xdze2/trois_molettes/docs/README.md

# Design docs

Requirements, part choices, and circuit/firmware design for the TroisMolettes AC
remote. There is no separate overview doc: start with
[00_specifications.md](00_specifications.md) for the requirements and the
stateless-interface principle, then each numbered file goes deep on one subsystem
(the `A*` files are technical annexes — reference, not reading order). Full file
list: see the table in the [root README](../README.md#files). Bench logs (what's
proven on real hardware) are in [`../howtos/`](../howtos/).

For what v1 leaves open and the planned v1.2 / v2 milestones (power, PCB,
enclosure), see [roadmap.md](roadmap.md).
