xdze2/trois_molettes/images/circuit/rc001.png

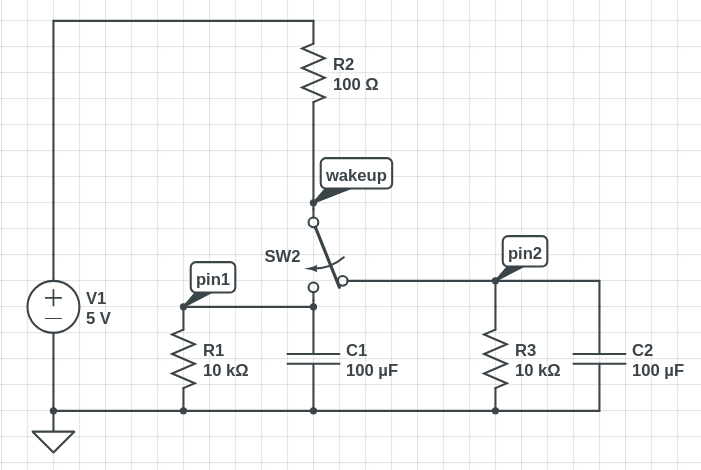
images/circuit/rc001.png
