xdze2/trois_molettes/images/daikin_remote_web.png

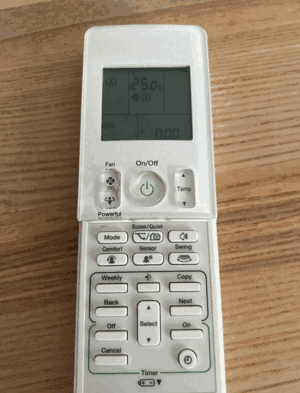
images/daikin_remote_web.png
