xdze2/trois_molettes/images/daikin_unit_web.png

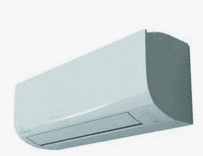
images/daikin_unit_web.png
