xdze2/trois_molettes/images/inspi_web.png

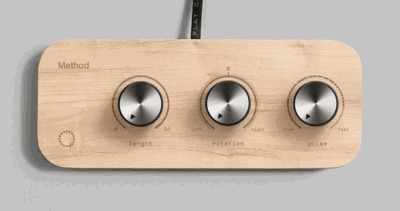
images/inspi_web.png
