xdze2/trois_molettes/images/photos/PXL_20260619_180518531_web.jpg

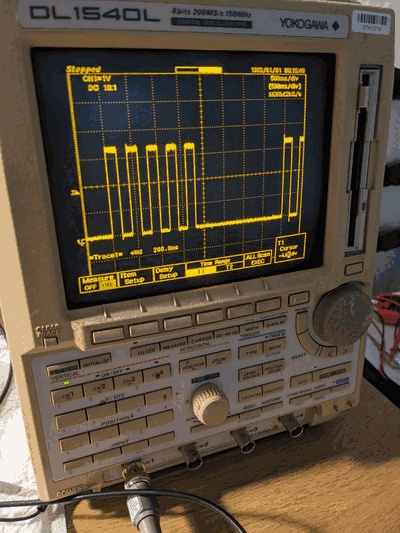
images/photos/PXL_20260619_180518531_web.jpg
