xdze2/trois_molettes/images/photos/PXL_20260624_193416426_web.jpg

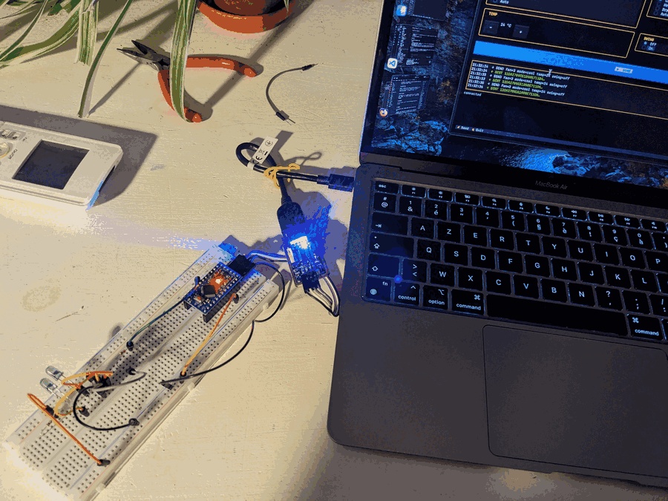
images/photos/PXL_20260624_193416426_web.jpg
