xdze2/trois_molettes/images/rotary_switch/ SR1712F-0108_alpha_web.png

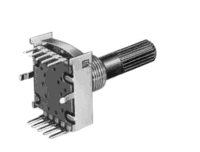
images/rotary_switch/ SR1712F-0108_alpha_web.png
