xdze2/trois_molettes/images/rotary_switch/ec11_web.png

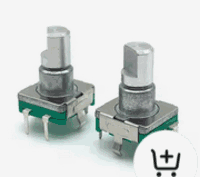
images/rotary_switch/ec11_web.png
