xdze2/trois_molettes/images/rotary_switch/Grayhill_56_web.png

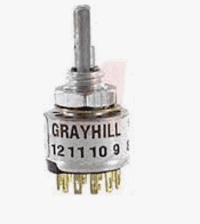
images/rotary_switch/Grayhill_56_web.png
