xdze2/trois_molettes/images/rotary_switch/ky040_ec11_web.png

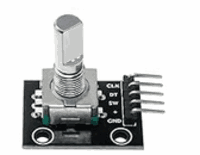
images/rotary_switch/ky040_ec11_web.png
