xdze2/trois_molettes/images/rotary_switch/NKK_MR-K112_web.png

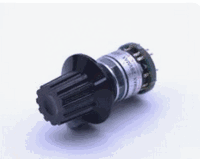
images/rotary_switch/NKK_MR-K112_web.png
