xdze2/trois_molettes/images/rotary_switch/sr10010F_Alpha_web.png

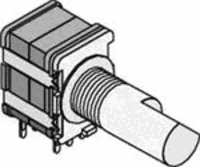
images/rotary_switch/sr10010F_Alpha_web.png
