xdze2/trois_molettes/images/shopping_cards.png

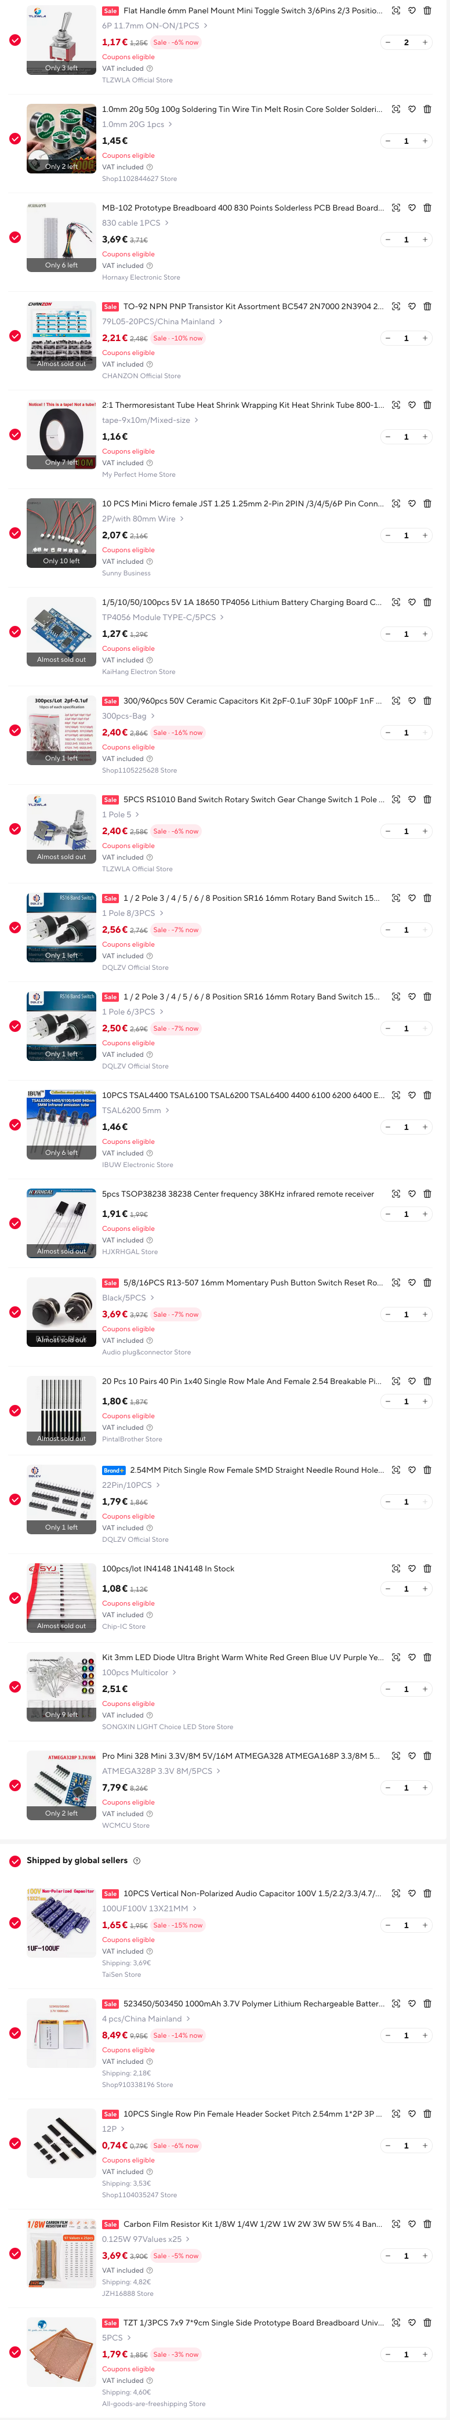
images/shopping_cards.png
