xdze2/trois_molettes/docs/06_IR_LED_wiring.md

# 06 — IR LED Wiring (TSAL6200)

Target: **ATmega328P Pro Mini 3.3 V**, powered from 2× AA/AAA or Li-Po (~3.0–3.3 V).
No boost converter — everything runs at 3.3 V.

## TSAL6200 Key Specs

| Parameter | Value |
|---|---|
| Peak wavelength | 940 nm |
| Max continuous current (If) | 100 mA |
| Max peak current (pulsed, 1/3 duty) | 1 A |
| Forward voltage (Vf @ 100 mA) | ~1.35 V |
| Half-angle | ±17° |
| Radiant intensity @ 100 mA | ~80 mW/sr |

The ±17° beam is focused — useful for range, but alignment matters.

## ATmega328P GPIO Constraints

- GPIO max source current: 40 mA per pin (20 mA recommended)
- A transistor is required to drive the LED at useful power

## Headroom at 3.3 V

```
Available across resistor = Vcc - Vf - Vce_sat
                          = 3.3V - 1.35V - ~0.2V  ≈  1.75 V
```

Vf rises slightly at high current (~1.5 V at 300 mA) — keep per-LED current at
**100 mA max** to stay in a predictable operating region with this supply.

## Single LED — Basic Circuit

Drive at **100 mA peak, 38 kHz, 1/3 duty cycle**.

```
R = (3.3V - 1.35V) / 0.1A = 19.5 Ω  → use 18 Ω or 22 Ω
R_base = 2.2 kΩ  (GPIO at 3.3V: 3.3V / 2.2kΩ ≈ 1.5 mA into base, hFE×Ic headroom fine)
```

**Transistor:** S9013 H331 (Ic_max 500 mA, TO-92) — well within ratings.

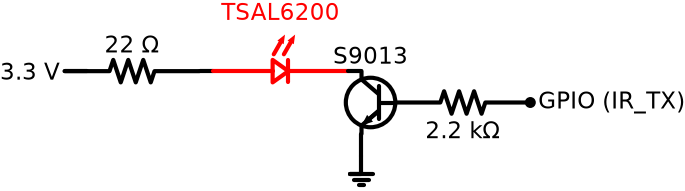
[picture p26: schematics/ir_led_single.png]
Single LED circuit


Current flows left → right: **3.3 V → 22 Ω → LED → transistor → GND**.

**Package orientation (TSAL6200, 5 mm radial):**

- **Anode** (long lead, round side of the package) faces the **22 Ω resistor / 3.3 V** side.
- **Cathode** (short lead, marked by the **flat** on the package rim) faces the **transistor collector** side.
- So the **flat faces the transistor**. Current path: 3.3 V → R → anode → cathode → collector → emitter → GND.

**S9013 (NPN, TO-92, flat face forward): E – B – C** (left to right, per datasheet):

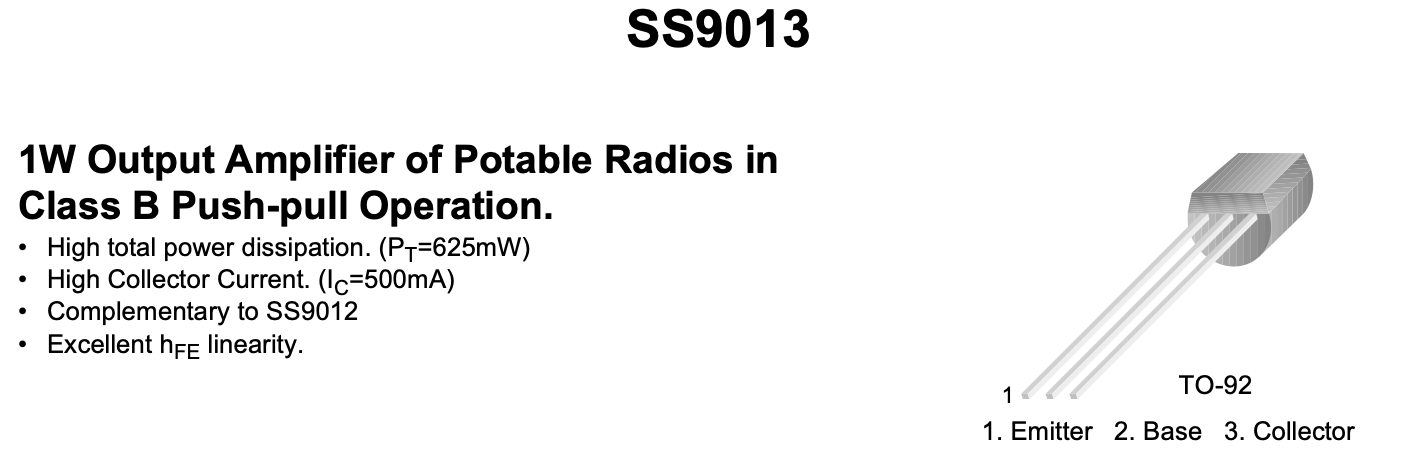
[picture p27: images/transistor_ss9013.png]
S9013 TO-92 pinout


- **Emitter (E, left)** → **GND**.
- **Base (B, centre)** → through R_base (2.2 kΩ) to the **GPIO**.
- **Collector (C, right)** → the **LED cathode**.

Range: ~2–3 m with a single LED at 100 mA. Use the multi-LED version for 3–4 m.

## Multi-LED Version — Widening the Angle

3 LEDs pointed in different directions (0°, ±30°) widens coverage to ~±47°,
and triples total radiant power for better range.

### Wiring: 3 LEDs in parallel, each with its own series resistor

Each LED gets its own resistor to balance current (never share a single resistor).

```
If per LED  = 100 mA
If_total    = 3 × 100 mA = 300 mA  →  S9013 (500 mA) handles this comfortably
R per LED   = (3.3V - 1.35V) / 0.1A = 19.5 Ω  → use 18 Ω or 22 Ω each

R_base (3× LEDs): Ib needed = Ic / hFE_min = 300 mA / 144 ≈ 2.1 mA
                  With 2× saturation margin: Ib_target ≈ 4.2 mA
                  R_base = (3.3V - 0.7V) / 4.2 mA ≈ 620 Ω  → use 680 Ω
```

> **Do not reuse the single-LED R_base of 2.2 kΩ here.** At 300 mA collector
> current, 2.2 kΩ gives only ~1.4 mA base current — below the ~2.1 mA needed
> for saturation. The transistor stays in active region, Vce rises to ~0.8 V,
> and LED current is lower than calculated.

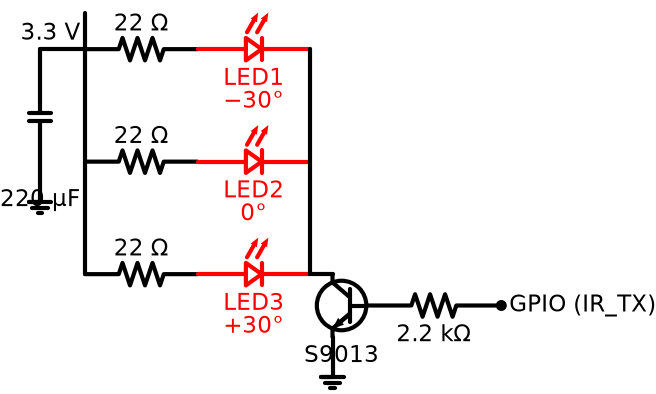
[picture p28: schematics/ir_led_3x.png]
3-LED circuit with bulk cap


### Angular coverage

| Config | Half-angle | Effective coverage |
|---|---|---|
| 1 LED | ±17° | ~34° cone |
| 3 LEDs (0°, ±30°) | ±17° each | ~±47° effective |
| 3 LEDs (0°, ±45°) | ±17° each | ~±62° effective |

## Bulk Capacitor — Rail Stabilisation

2× AA batteries have significant internal resistance (~0.5–2 Ω, rising toward end of life).
A 300 mA IR pulse causes a rail sag that can reset the MCU:

```
Sag = If_peak × R_internal = 300 mA × 1.5 Ω = 0.45 V  ← dangerously close to MCU brownout
```

A bulk capacitor placed close to the transistor/VCC node supplies the transient current
locally and keeps the rail stable. It does not increase LED current — it prevents the
voltage from drooping below the calculated value.

**Sizing:**
```
C ≥ If_peak × t_pulse / ΔV_allowed
  = 300 mA × 600 µs / 0.1 V
  ≈ 1800 µF for ΔV < 100 mV
```

In practice a single large cap isn't needed — the Daikin frame is a series of short
bursts, and the battery recovers between marks. **100–470 µF** is the practical range:

| Value | Notes |
|---|---|
| 100 µF | Minimum — fine for fresh batteries |
| 220 µF | Good default |
| 470 µF | More comfortable at end-of-life batteries |

Use an electrolytic, placed physically close to the collector/VCC node. Polarity matters.

## Wall-Mount Coverage — Wide Angle vs. Range

The TSAL6200's ±17° half-angle is chosen for range, which cuts against a
wall-mounted remote that could sit on any wall and must reach an AC unit
somewhere in the room. The instinct is "use a wide-angle LED," but that trades
away the wrong thing: the same radiant flux spread over a wider solid angle means
lower intensity in every direction (conservation of étendue). Wide-angle IR parts
(OP165W ±90° ~0.5 mW, OP293 ±30° low output) are low-power signalling emitters,
~10–100× weaker than the TSAL6200 — swapping to one guts the range. Don't
downgrade the emitter to buy angle.

Two things work in our favour instead: IR bounces well off walls/ceiling/furniture,
so direct line-of-sight across a full hemisphere usually isn't needed; and the AC
unit sits in a fixed, known direction, so the remote only needs to cover that arc
plus spill for bounce — not a true 180°.

### Strategy A — Multi-LED fan (keep the strong emitter)

3–5× TSAL6200 fanned across the horizontal (e.g. 0°, ±40°, ±80°) gives a
near-continuous high-intensity fan approaching ~160–180° with full range the whole
way. 5 LEDs at ~60 mA each = 300 mA still fits the S9013 (500 mA). Build the
documented 3× version and test in the real room first — direct + bounce often
covers more than the angle math suggests.

### Strategy B — Optics (aesthetic + horizontal beam-shaping)

A lens can't create coverage, only redistribute flux the LED already emits — a
symmetric diffuser turns a strong narrow LED into a weak wide one. But shaping is
useful: a cylindrical/lenticular lens spreads the beam horizontally while keeping
it tight vertically (floor/ceiling flux is wasted on a wall mount anyway; can turn
±17° symmetric into ~±50° H / ±17° V), and a tinted IR-pass window (the dark-red
plastic over every TV remote) hides the LEDs at near-zero optical cost — worth
doing regardless. Optics are for aesthetics and horizontal shaping, not a
substitute for multiple emitters.

### Strategy C — Aimable head (directional mount)

Sidesteps the étendue problem: keep the TSAL6200's full focused beam and aim it
once at install time. The AC never moves, so this is a mechanical positioning
problem, not a motor problem — skip motorised aiming, since a servo adds power
draw (bad for a µA-sleep battery remote) and noise for no benefit once set.

| Mechanism | Axes | Wiring across joint | Notes |
|---|---|---|---|
| **Ball-and-socket / friction gimbal** | pan + tilt | flexible leads / flat-flex through socket | Recommended. GoPro/camera-ball style, friction holds aim, no power to hold |
| Detented turntable | pan only | flex with ±180° stop, or keep PCB on platter | Click detents like a thermostat dial; slip-ring is overkill |
| Flip-up hinge panel | tilt only | hinge-routed leads | Friction hinges, good if AC is roughly in front |

A small reflector cup or lens hood behind the LED tightens the on-axis beam for
extra range and a clear "this points at your unit" affordance. Keep 3× TSAL6200
in the head for install tolerance.

**Recommendation order:** build the 3× fan and test in-room → if dead spots, go
5× fan → add lenticular/diffuser + tinted window for blend & aesthetics → use an
aimable friction-gimbal head if focused range with a deliberate point-at-the-AC
interaction is wanted.

## Component Summary

| Component | Value | Notes |
|---|---|---|
| TSAL6200 | × 1 or × 3 | 940 nm, ±17°, 100 mA |
| Q1 NPN | S9013 H331 | Ic 500 mA, hFE 144–202 (H group), TO-92, EBC pinout |
| R_base | 2.2 kΩ (1× LED) / 680 Ω (3× LEDs) | GPIO → base; value depends on total Ic |
| R_series | 22 Ω each | 100 mA per LED at 3.3 V |
| C_bulk | 220 µF electrolytic | rail stabilisation, close to Q1 collector |

## Notes

- **S9013 pinout (TO-92, flat face forward): E – B – C** (left to right, per datasheet). Same order as BC337 — but always verify against the datasheet before soldering, since other 9013 variants and clones sometimes differ.
- At 1/3 duty cycle (Daikin/NEC encoding), average current per LED is ~33 mA — well within continuous ratings.
- The IRremote library (AVR target) handles the 38 kHz carrier via timer — no manual toggling needed. **The send pin must be a hardware timer output: use pin 3 (OC2B, Timer 2, IRremote default).** Arbitrary GPIO pins (e.g. pin 2) only produce the mark/space envelope without the 38 kHz carrier — the AC will not respond.
- For the multi-LED version, bend the outer LEDs to the target angle before soldering; a small cardboard jig helps keep angles consistent.
- Desolder the Pro Mini power LED before measuring sleep current — it draws ~1 mA continuously and dominates the sleep budget.
