xdze2/trois_molettes/datasheets/rs1010_wiring.webp

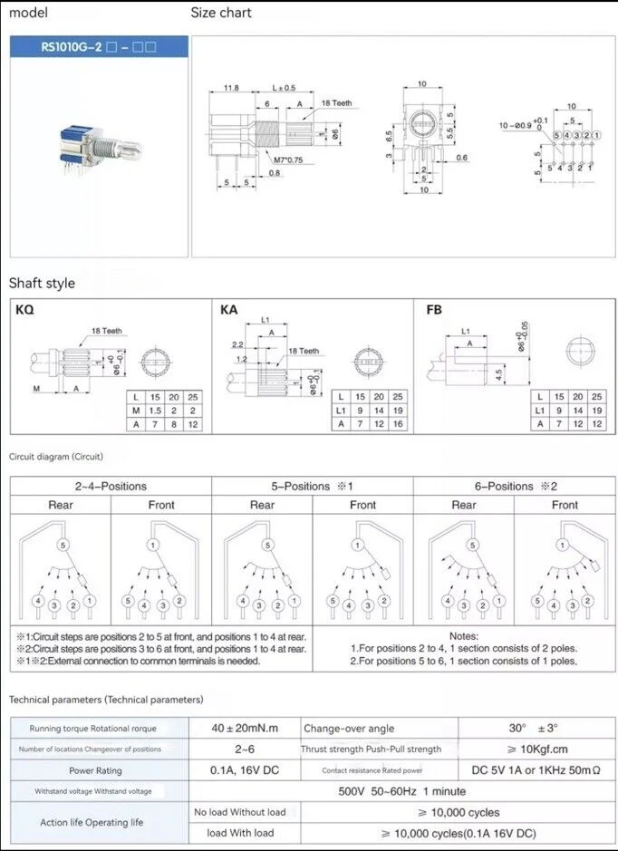
datasheets/rs1010_wiring.webp
