xdze2/trois_molettes/(commit log)

2026-06-02 Init draft project
    [02_BOM_prototype.csv]
2026-06-02 Update rotary switches
2026-06-03 Revise wake/readout design, split electronics into 05
    - Fix wake mechanism: alternating-contact 2P pole (was "all contacts to
    3.3V", which collapsed into the rejected float method)
    - Add honest battery budget: stock Pico ~1.3 mA, gated ladder rail, 6-month
    target as open bench-validation item
    - Drop WS2812B chain (incompatible with battery target; knob position is the
    state)
    - Extract circuit-level content into new 05_electronics_circuit.md; 04 keeps
    switch selection only
    - Reconcile mode count (4), BOM 2P parts, gated rail, cross-references
    [02_BOM_prototype.csv]
2026-06-03 Converge on diode-encoded 1P switch readout; restructure docs
    Design decision: all three rotary switches are plain 1-pole, diode-encoded
    into a small binary code on their own GPIO; the code lines double as
    both-edge wake interrupts. Drops 2-pole switches, resistor ladders, ADC,
    analog rail, and comparator — switches now chosen on feel and size alone.
    - Document Options C (off-the-shelf coded switch) and D (DIY diode-encoded)
    alongside the earlier A/B; mark A/B/C considered, D chosen
    - Fix wake: per-line both-edge interrupts, not a single OR'd pin (which
    misses non-zero->non-zero moves)
    - Fix power coupling: wiper supply can't be gated (kills wake); use weak
    pull-downs for low leakag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
    [02_BOM_prototype.csv]
2026-06-03 Rethink MCU choice on sleep current + 13-pin wake; drop RP2040
    The device sleeps ~100% of the time, so sleep current is effectively the
    whole battery budget, and the diode-encoded readout needs both-edge wake
    on ~13 GPIO. Reframe the MCU constraints around these two (plus a
    perfboard/dev-board-only build rule), and demote the IR library to a
    convenience now that porting the Daikin frame is accepted.
    This inverts the previous pick: the RP2040 Pico board sleeps at ~1-1.8 mA
    (~9 weeks, misses 6 months) and its bare-chip fix needs a PCB the
    perfboard rule forbids; cheap ESP32-C parts expose only 6-8 deep-sleep
    wake pins (<13). New shortlist that clears both gates: nRF52840 (XIAO,
    preferred, ~1.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
    [02_BOM_prototype.csv]
2026-06-19 IR leds
2026-06-19 Add portable Daikin frame builder and software architecture doc
    - firmware/daikin_frame.{h,cpp}: pure C++ AC state → 35-byte frame builder,
    no library dependency, verified byte-for-byte against IRDaikinESP reference
    - ir_mock/main.cpp: updated to diff portable builder output against the full
    library; exits non-zero on any mismatch
    - 10_software_architecture.md: documents the 3-layer split (app / frame / HAL),
    Linux mock verification workflow, and open items
    - ir_mock/IRremoteESP8266: registered as git submodule
2026-06-21 Add wiring diag for the rs1010
2026-06-22 Add IRQ/LED test sketch, serial test sketch, and serial debug howto
    Documents the CKDIV8 fuse issue (4 MHz effective clock, baud rate
    factor-of-2 workaround) and explains BOD, ISP, and fuse options.
    [serial_test.ino]
2026-06-22 Add RS1010 readout test sketches and bench-notes howto
    Two sketches in tools/ for the diode-encoded rotary switch wiring:
    polling-only (rs1010_poll_test) and SLEEP_MODE_PWR_DOWN + PCINT wake
    (rs1010_wiring_test). Both implement the §7 two-agreeing-reads debounce
    to defeat the inter-detent zero glitch (10 ms settle, 5 ms was too low).
    howtos/03_rs1010_readout.md captures the bench findings and pitfalls
    (INPUT vs INPUT_PULLUP, millis() in power-down, LED_BUILTIN in PCI group).
2026-06-22 Update specs and circuit docs to reflect actual design choices
    - Controls: 8-pos SR16 for fan/temp, 5-pos RS1010 for mode, Send button, optional swing toggle
    - Temperature uses 2°C steps with mode-dependent offset (heating 14–28°C, cooling 20–34°C)
    - Add feedback LED (PC3) to GPIO listing
    - Rewrite 05_electronics_circuit.md focused on ATmega328P diode encoding (all 3-bit)
    - Add 07_battery_and_power.md covering power architecture, sleep budget, Pro Mini mods
    - Add bench photo and wiring schema to howtos/03_rs1010_readout.md
    - Ignore datasheets/ directory
2026-06-23 Add IR receiver signal howto with oscilloscope bench notes
    TSOP38238 circuit, measured Daikin frame structure (leader + 3 frames),
    and bit-level timing (475 µs mark, pulse-distance encoding), with photos.
2026-06-23 Ir led with S9013
2026-06-23 Tst ir led
2026-06-23 Add IR modulation test howto and rename sketches
    - Add howtos/05_ir_modulation_test.md with bench notes, scope images,
    and CKDIV8 timing workaround (HALF_PERIOD_US 4 → ~36 kHz measured)
    - Rename ir_led_test → ir_modulation_test to distinguish from upcoming
    Daikin protocol test
    - Rename irq_led_test → pcint_test to avoid confusion with IR sketches
    [ir_modulation_test.ino]
2026-06-23 Add daikin_fan_toggle sketch and howto
    First end-to-end test of a real Daikin frame over the IR LED: Timer2
    38 kHz carrier, portable frame builder, 3-section pulse encoder.
    Alternates fan MIN/MAX every 30 s so the AC unit itself is the loopback.
2026-06-23 Recalibrate Daikin carrier for 8 MHz and blink LED on send
    Scope measurement (66.7 kHz at OCR2A=58) proved CKDIV8 is not active,
    so the 4 MHz/CKDIV8 compensations were wrong: removed `/2` from
    delayMicroseconds(), set OCR2A=104 for 38.1 kHz, kept Serial at 4800
    baud as-is. LED_BUILTIN now lights for the duration of each frame
    plus 400 ms so transmissions are visible.
    Howto's "Clock note" section now documents the misdiagnosis and the
    measurement that disproved it — heads-up for the other sketches that
    still carry the same CKDIV8 assumption.
    [daikin_fan_toggle.ino]
2026-06-23 Resolve merge conflict in fan toggle howto
    Keep updated troubleshooting rows (4800 baud, OCR2A scope advice, symlink note)
    and status note from both sides.
2026-06-23 Add ir_rx_dump sketch and howto (not yet tested)
    Sketch listens on TSOP38238 (D2) and prints raw mark/space timings to
    serial — intended to capture the real Daikin remote output for byte-level
    comparison against daikin_build_frame().
2026-06-23 ir_rx_dump: iterate on timing capture, document failures and PCINT plan
    - Label output with LEADER/SECTION/--- markers for readability
    - Switch to 115200 baud to reduce Serial delay between measurements
    - Replace pulseIn() with micros()-based helpers, then hybrid approach
    (both failed: pulseIn(HIGH) misses in-progress spaces; micros() polling
    loop has 8 µs resolution at 8 MHz and misses short transitions)
    - Document root cause: no safe place for Serial.print in the polling hot
    loop given 400 µs bit spaces vs 35 ms inter-section gaps
    - Document recommended next approach: PCINT edge-timestamp ring buffer,
    decode and print after full frame captured (end-of-frame >60 ms timeout)
    Co-Au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
    [capture.py, ir_rx_dump.ino]
2026-06-23 Rename howtos 06↔07, add IDE settings image to ir_rx_dump
    - 06_daikin_fan_toggle → 07_daikin_fan_toggle
    - 07_ir_rx_dump → 06_ir_rx_dump (capture comes before toggle)
    - Add images/arduino_ide_settings.png (Pro Mini, ATmega328P 3.3V 8MHz)
    - Reference image in 06_ir_rx_dump.md under new Arduino IDE settings section
2026-06-23 ir_rx_dump: working PCINT capture + reference fan-loop dump
    The sketch now produces strict mark/space alternation and one === per
    button press. Three bring-up bugs fixed: phase detection (inverted
    PIND read in the ISR), torn read of last_edge_time in loop() that
    triggered premature decoding mid-signal, and mid-frame ISR re-arm on
    buffer overflow that lost ~50 ms of edges to Serial.print. Buffer
    grown to 768 entries to fit a full Daikin press (frame + repeat) in
    one capture.
    Captured reference: howtos/data/dump_fan_loop.txt — ARC466A33 cycling
    the full fan-speed loop (auto → 1..5 → quiet → auto), ten frames, for
    use as ground truth when developing the decoder.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
    [dump_fan_loop.txt]
2026-06-24 Fix daikin_frame fixed bytes to match real ARC466A33 capture
    Decoding the checked-in fan-loop capture (howtos/data/dump_fan_loop.txt)
    revealed that daikin_build_frame() — a faithful port of the library's
    stateReset() — emitted five reserved/fixed bytes that the real remote
    never sends as zero. Since the AC unit checksums each section, these
    mismatches likely explain why it ignored the ATmega.
    - frame[5]=0x10, frame[13]=0x04, frame[14]=0x20 (section 1/2 reserved+clock)
    - frame[31]=0xC1, frame[32]=0x80 (section 3 reserved bits)
    All five are invariant across all 10 captured frames.
    ir_mock now diffs the builder against the decoded capture (the real
    ground truth) instead of the library d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
    [main.cpp]
2026-06-24 daikin_fan_toggle: fix gap/header timing to match real capture
    Diffing the sketch's pulse encoding against the real ARC466A33 capture
    (decoded in howto 07) showed it used the library's nominal single 29 ms
    gap everywhere, but the real remote uses ~25 ms after the preamble and
    ~35 ms between sections.
    - Split DAIKIN_GAP into DAIKIN_LEADER_GAP (25 ms) and DAIKIN_SECTION_GAP
    (35 ms); send_section() now takes the gap as a parameter.
    - Nudge HDR mark/space to the measured ~3500 / ~1700 µs.
    - Frame content needs no sketch change: it flows from the already-fixed
    daikin_build_frame().
    Update howto 08 timings/structure and refresh the stale "does not
    respond" status: both root causes (checksum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
    [daikin_fan_toggle.ino]
2026-06-24 Fix S9013 pinout (E-B-C) and add visible-LED sanity check
    The S9013 datasheet pinout is E-B-C (centre = base), not E-C-B as howto 06
    previously claimed. The wrong pinout left the LED forward-biased through the
    base-emitter junction permanently — LED always on, GPIO toggling did almost
    nothing useful.
    The original modulation test (howto 05) still passed with the wrong wiring
    because a TSOP38238 at a few cm has enough AGC and sensitivity to demodulate
    the small 38 kHz ripple riding on the DC-on LED. That false positive is now
    documented as a trap.
    - 06_IR_LED_wiring.md: correct pinout to E-B-C with datasheet image
    - howtos/05_ir_modulation_test.md: add Step 0 visible-LED sanity check and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
    [ir_led_blink.ino]
2026-06-24 daikin_fan_toggle: fix long-gap truncation, working end-to-end
    delayMicroseconds() is only accurate up to ~16 ms, so the 25 ms leader
    and 35 ms inter-section gaps silently collapsed to near-zero and fused
    all three sections into one ~300 ms burst — AC ignored the frame.
    Add ir_space_long() that chunks long waits into 16 ms delay() slices,
    route the leader and section gaps through it. AC now beeps and changes
    fan speed on every transmission; reliable range ~2–3 m with a single LED.
    [daikin_fan_toggle.ino]
2026-06-24 docs: reconcile design docs to as-built (ATmega328P, IR on PD3/OC2B)
    The docs had drifted from the validated, tested design. Most important fix:
    the IR TX pin was documented as PD7 (OC2A) but the working end-to-end firmware
    drives PD3 (OC2B) via Timer2 — soldering to the doc'd pin would have used a
    dead GPIO. Corrected and marked PD3 as hardware-locked; reassigned Temp to
    PD4-6, Send to PD2, Swing to PD7 around it.
    Also reconciled:
    - MCU: nRF52840-as-preferred -> ATmega328P locked (README, 01, 10, 01_IR)
    - dead links: 07_power_and_ir.md -> 07_battery_and_power.md / 06_IR_LED_wiring.md
    - controls: 4 buttons -> Send + optional Swing
    - positions: stale 6/4/11 -> 8/5/8
    - sleep floor: nRF ~2uA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
2026-06-24 docs: link bench logs from README, fix stale refs in rs1010 howto
    Add a "Bench logs (build journal)" section to the README linking all eight
    howtos/ logs, and complete the design-docs Files table (was missing 06/07/10).
    The howtos are the real record of bringing each subsystem up on hardware.
    Reconcile drift in howtos/03_rs1010_readout.md:
    - cross-refs pointed to a §3.5/§6/§7/§8 layout 05 no longer has -> §2/§3/§5
    and the sleep budget now in 07_battery_and_power.md
    - "11-position temp switch needs 4 lines" -> final design is 8-pos / 3 lines
    - "final target MCU (nRF52840, ~2 uA floor)" -> ATmega328P, LDO ~75 uA floor
    06_IR_LED_wiring.md left out (separate pre-existing change).
    Co-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
2026-06-24 docs: add serial remote app (Textual TUI) spec
    Plan for a Python Textual soft front-panel that drives the real AC over
    serial -> ATmega328P -> IR LED, reusing the validated transmit path
    (daikin_build_frame -> send_daikin -> Timer2 carrier).
    Design keeps Python thin: the 328P owns the protocol (frame bytes,
    checksums, timing — already validated), the TUI sends intent as line
    commands (FAN/MODE/TEMP/SEND) and renders replies. Covers the serial
    protocol, a near-trivial daikin_serial firmware refactor, the app module
    layout (incl. a mock backend to build the UI with no board), and frame
    parity verification via the SENT <hex> reply.
    Linked from the README Files table.
    06_IR_LED_wiring.md le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
2026-06-24 docs: add integration roadmap to README
    Record the milestone (all three subsystems individually proven) and the
    three-phase integration plan, each phase de-risking the next:
    1. Python serial app — exercise the full control mapping from a TUI before
    committing it to physical knobs
    2. Wood-panel prototype — encoders + devboard + battery; settle LED mount,
    knob feel, real-room range, measured sleep current
    3. Proper case + better wiring (PCB?) — once the prototype fixes the real
    dimensions and layout
    Also fix two stale bits in the Hardware summary passed through: "4 tactile
    buttons" -> Send + optional Swing, and a dead section anchor on the 05 link.
    06_IR_LED_wiring.md left ou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
2026-06-24 daikin_tui: rewrite UI around single-source state, send-on-change
    - TUI: replace RadioSet/per-widget state with a central state dict in
    DaikinApp; OptionGroup and TempControl are stateless renderers driven
    by render_state(). Every picker click / temp bump / Enter on a focused
    button immediately sends the current snapshot. Green highlight tracks
    last-successfully-sent value, so the UI mirrors the AC's actual state.
    Standalone button kept as RESEND.
    - Arrow keys aliased to Tab/Shift-Tab at app level (pure focus motion,
    one focus indicator instead of two).
    - backend: swap pyserial-asyncio for blocking pyserial in to_thread —
    matches capture.py and dodges CH340 DTR reset quirks d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
    [app.py, backend.py, daikin_serial.ino]
2026-06-27 fix: correct R_base for 3-LED config and warn about IRremote pin requirement
    2.2 kΩ is insufficient to saturate the S9013 at 300 mA — use 680 Ω.
    Add warning that IRremote requires pin 3 (OC2B) for the 38 kHz carrier.
2026-07-08 docs: add Arduino Pro Mini pin map, battery wiring, and GPIO image
    - Add pin-assignment table with Arduino Pro Mini silkscreen labels
    alongside AVR port names in 05 §1.
    - Add power/non-GPIO table: TP4056 OUT+/OUT- -> Pro Mini RAW/GND.
    - Fix stale Send/Swing pins in §4 (PD5/PD6 -> PD2/PD7) to match §1.
    - Embed images/circuit/gpios.png.
2026-07-08 Revert ir led pin chg
    [ir_led_blink.ino]
2026-07-08 Add polling test sketch for all 3 rotary switches
    Reads Fan/Mode/Temp code lines and prints bits + decoded meaning on
    serial. Includes a raw-code -> position remap for the Fan switch
    (diode encoding is shifted by one position) and a capture.py helper
    matching the ir_rx_dump pattern.
2026-07-08 Document Fan/Mode rotary switch bring-up findings
    Bench notes on the diode-shift bug (Fan) and pin-swap bug (Mode) found
    via rotary_switches_poll_test, plus next steps: wire Temp, IR+Daikin
    end-to-end test, sleep mode, and battery test.
2026-07-08 Add daikin_knob_remote sketch: Fan/Mode knobs transmit IR on change
    Combines the validated Fan+Mode readout from rotary_switches_poll_test
    with the IR TX path from daikin_serial, wired straight from change-detect
    in the poll loop rather than a Send button. Confirmed against the real
    Daikin unit. Temp is not yet wired so it's held at a fixed default.
    [capture.py, daikin_knob_remote.ino]
2026-07-15 Wire Temp knob and Resend button; fix Resend pin polarity
    daikin_knob_remote: read the Temp switch (D4/D5/D6) instead of a fixed
    24C default, applying the mode-dependent 2C-step offset. Add a Resend
    button (D2) that retransmits the current knob state on demand, on top
    of the existing auto-send-on-knob-change behavior.
    rotary_switches_poll_test: add Resend button polling alongside the
    existing Fan/Mode/Temp switch readout.
    Both sketches originally assumed the design doc's pull-up/active-low
    wiring for the Resend button, but the bench wiring uses an external
    pull-down with the button to +3.3V (active-high), matching the rotary
    switch code-line convention. Fixed pinMode/polarity in both sketc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
    [daikin_knob_remote.ino, rotary_switches_poll_test.ino]
2026-07-15 Consolidate per-sketch capture.py into tools/serial_capture.py
    Three sketches each carried a near-identical pyserial capture helper.
    Replace them with one shared tool; the sketch-specific --sends-only /
    --changes-only flags become a generic repeatable -f/--filter-prefix.
    [capture.py, ir_rx_dump.ino, serial_capture.py]
2026-07-15 Consolidate GPIO input bring-up into one sketch; align its baud rate
    rotary_switches_poll_test now covers every GPIO input in the design
    (Fan/Mode/Temp rotary switches, Resend, and Swing) in a single polling
    loop, so it's the one sketch to reach for during input bring-up. Removes
    gpio_test, pcint_test, rs1010_poll_test, and rs1010_wiring_test, whose
    functionality it supersedes.
    Also switches it from 9600 baud (no clock fix) to 115200 with the CKDIV8
    clear used by daikin_serial/daikin_knob_remote/ir_rx_dump, so the whole
    modern sketch chain shares one baud rate and doesn't depend on whether
    the board's bootloader quirk is present.
    [rotary_switches_poll_test.ino]
2026-07-15 Rework rotary_switches_wake_test to sleep + wake on PCINT, print only changes
    The bring-up sketch was pure polling with a 5s heartbeat print. Reworked
    loop() to sleep in SLEEP_MODE_PWR_DOWN and wake only on a pin-change
    interrupt, arming all three PCI groups (Fan on PCIE0, Mode on PCIE1, Temp/
    Resend/Swing on PCIE2) per 05_electronics_circuit.md §5. On wake it
    debounces and prints only what actually changed — nothing prints while
    idle, and there's no more heartbeat tick.
    Renamed rotary_switches_poll_test -> rotary_switches_wake_test (folder,
    .ino, howto doc) to match the new behavior, and updated cross-references.
    [daikin_knob_remote.ino, rotary_switches_wake_test.ino]
2026-07-15 Fix Temp knob b0/b2 pin swap in wake-test and knob-remote sketches
    Bench testing showed Temp code lines are wired D6(b0)/D5(b1)/D4(b2), not
    D4/D5/D6 as the design doc lists — swapping the pin order in the read
    array now yields monotonic 0-7 codes matching the intended encoding table.
    [daikin_knob_remote.ino, rotary_switches_wake_test.ino]
2026-07-17 docs: move design docs into docs/, add docs index, drop research clippings
    - Move 00_*–11_* design docs from repo root into docs/ (root now holds
    only README.md and CLAUDE.md); fix all cross-links accordingly
    - Add docs/README.md as an index for the design docs
    - Delete raw AI-chat/web clippings (old docs/) and the orphaned links.md stub
    - Add missing howtos/09 row to the README bench-logs table
    [02_BOM_prototype.csv]
2026-07-20 wip: SKiDL netlist generator for KiCad PCB import
    Add schematics/circuit.py — a self-contained uv/SKiDL script that describes
    the full remote circuit in Python and emits a KiCad netlist (circuit.net) for
    import into Pcbnew. Diodes are generated from the position->bit tables in
    docs/05, so those tables stay the single source of truth.
    WIP: footprints intentionally unset (assigned at layout time); no BOM yet;
    Pro Mini represented as two 1x12 headers. Netlist connectivity spot-checked
    but not yet round-tripped through a real KiCad import.
    Also fix docs/05 diode count: Mode is 5 diodes not 4 (popcount over its 5
    positions), total 29. Gitignore the generated netlist, SKiDL side files, and
    the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
    [circuit.py]
2026-07-20 docs: simplify and de-duplicate design docs, merge rotary switch doc into circuit doc
    Trim repeated rationale and sales-pitch bolding across the README and docs/*.md,
    drop the docs/README.md file table that duplicated the root README's, delete a
    stale section in 01_IR_protocol_and_mapping.md describing an old control layout,
    and reframe 03_microcontroller_choice.md's decision section to match the
    already-locked ATmega328P choice stated elsewhere. Merge
    04_rotary_switch_choice.md into 05_electronics_circuit.md as a new "Switch
    selection" section, since part choice and wiring are two halves of the same
    subsystem.
2026-07-23 docs: add AAA/alkaline (and 9V) battery alternative to Li-Po
    Discuss primary alkaline cells as an alternative to the Li-Po + TP4056
    stack: capacity vs Li-Po, the voltage question (2xAAA direct-drive of
    the 328P removes the LDO quiescent floor), 9V pack drawbacks, and
    trade-offs. Cross-reference IR/readout low-voltage validation.
2026-07-23 docs: rewrite software architecture doc to match the actual firmware
    10_software_architecture.md described a pre-implementation design (HAL
    split between AVR/Linux, inputs.h pin-assignment table, sleep+ISR main
    loop) that was never built. The real daikin_knob_remote.ino is a flat
    polling sketch with no HAL abstraction. Rewrite the doc to describe what
    exists: switch reading/debounce, knob-position-to-ACState mapping, the
    shared daikin_frame layer, IR transmit, and what ir_mock actually does.
2026-07-23 refactor: single raw-indexed table per knob + 3-line serial log
    Collapse each knob's mapping into one declarative table indexed directly
    by the raw gpio code (FAN_POS/MODE_POS), removing the FAN_RAW_TO_POS remap
    array and the duplicated switch statements in fanMeaning/modeMeaning and
    applyFanPos/applyModePos. Label and ACState value now live in the same row
    so they can't drift; any diode shift / pin swap / reversal is absorbed into
    the row order.
    Fan and Mode row orders set from hardware testing (Mode reads reversed vs.
    the old howto 09 order; one Fan position has a suspected broken solder joint,
    annotated in the table).
    Serial log is now three grouped lines per transmit: CHANGE (moved kno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
    [daikin_knob_remote.ino]
2026-07-23 fix: align knob comments and fail-safes with the raw-indexed tables
    The raw-indexed refactor reordered the Fan/Mode rows but left several
    comments describing the old order, and two out-of-range fallbacks
    clamping to what used to be Off/Auto:
    - Fan/Mode summary comments now match the tables (Off=raw1/Auto=raw0;
    Mode raw 0..4 = Auto/Dry/Heat/Cool/Fan).
    - applyFanPos out-of-range clamps to index 1 (Off), not 0 (now Auto).
    - applyModePos out-of-range clamps to index 0 (Auto), not last (now Fan).
    Only affects out-of-range readings; normal behavior unchanged.
    [daikin_knob_remote.ino]
2026-07-23 feat: 1°C temp step, reversed raw-code knob table + Gray-code/shorting notes
    Temperature knob now steps 1°C instead of 2°C: HEAT 14-21°C, COOL 24-31°C.
    The knob is wired reversed (raw 0 = rightmost = warmest), so the mapping moves
    from a formula to a per-mode TEMP_C[isHeat][raw] lookup table, absorbing the
    wiring reversal in row order like the Fan/Mode knobs. Also raise the knob
    settle time (SETTLE_MS 10->20, MAX_SETTLE_TRIES 20->30).
    Docs: rewrite 00_specifications §4.3 and 05_electronics_circuit §3/§7 to the
    new raw-indexed 1°C table, and add notes on Gray-code encoding (one-bit-per-
    step, removes the transient-decode/debounce need) and shorting vs non-shorting
    switch contacts.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
    [daikin_knob_remote.ino]
2026-07-23 docs: polish v1 spec + mark deferred decisions as v2 in circuit doc
    - 00_specifications: present-tense polish, restore §5 Feedback and fix
    section numbering, describe the temp knob by physical detent orientation
    (left→right) instead of raw GPIO code, tidy alternatives/nice-to-have.
    - 05_electronics_circuit: reframe shorting-vs-non-shorting, Gray-code-vs-
    debounce, and the soft wiring-fix table as explicit v2 decision callouts,
    kept per-topic in place.
2026-07-23 docs: make IR protocol an annex, drop redundant design overview
    - rename 01_IR_protocol_and_mapping.md -> A1_ (technical annex, out of the
    numbered reading sequence); add annex banner + spec §8.1 listing the
    frame constraints it imposes (memory/timer/carrier)
    - delete 01_technical_design_overview.md: its per-subsystem summaries just
    restated the leaf docs and would drift; salvage the cross-cutting synthesis
    (design tension + open-questions dashboard) into docs/README.md
    - update all inbound links (root README table, docs/README, 03, 10, howtos/04,
    firmware comments)
    [daikin_knob_remote.ino]
2026-07-23 docs: reconcile MCU choice + add no-SMD constraint, elevate 2xAAA power path
    - add "no surface-mount assembly" as a hard non-functional requirement (00 §8)
    and a hard gate in the MCU constraints table (03)
    - reconcile the ATmega328P as the chosen/built-v1 part everywhere (03 §5, BOM):
    demote nRF52840/STM32L4 to explicit v2-if-needed alternatives, tagged with
    their castellated-SMD + XIAO pin-count caveats
    - make 2xAAA direct-drive (no regulator, ~4 µA floor) the recommended power
    architecture (07 §1/§6, BOM, README); Li-Po + TP4056 becomes the fallback,
    gated on the ~1.8 V IR/readout bench checks
    [02_BOM_prototype.csv]
2026-07-23 docs: correct Gray-code claim, record strobe-line vs debounce fork
    Gray code does not fix the non-shorting float-to-000 transient (all lines
    drop to the valid Off code as a mechanical event, encoding-independent). It
    only helps contact skew and the shorting bridge.
    With 8 positions on 3 bits all codewords are used, so there is no spare
    pattern to reserve for "float / invalid". Reframe the v2 encoding decision as
    the real fork: add a per-switch strobe/valid line (A) vs keep rejecting float
    by debounce timing (C). Note B (reserve 000) is a dead end for the SR16 knobs.
2026-07-23 docs: add v2 coded-encoder route (Bourns PAC18R), reframe switch choice
    Reframe the rotary-selector choice as a v1→v2 fork: v1 plain 1-pole
    switch + diode matrix (AliExpress) vs v2 coded absolute encoder (Mouser).
    Add the Bourns PAC18R1-41D19F as the v2 candidate — 4-bit Gray code,
    8 positions, 2.5 mm-pitch THT, real flatted knob shaft, haptic detents.
    Being Gray-coded and self-encoding, it deletes the 29-diode array and
    retires the entire §1/§3 shorting/non-shorting transient problem, while
    staying perfboard-compatible (on the 2.54 mm grid) so no custom PCB is
    forced. Cost open: confirm Mouser price vs the ≤ €5/unit target.
    Correct §8-C (coded switches are not all screwdriver-s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
2026-07-23 docs: split 05_electronics_circuit into v1 (built) and v2 (evolution); add LICENSE
    05_electronics_circuit.md now covers only the built, bench-validated v1
    diode-matrix circuit. The PAC18R/coded-encoder evolution discussion moves
    to a new 05_electronics_circuit_v2.md. Updates cross-references in
    README, roadmap, and 03_microcontroller_choice accordingly, and fixes a
    stale anchor in 03_microcontroller_choice.md left over from an earlier
    heading rename.
    Add MIT LICENSE, matching the project's open-source requirement.
